gmoca/fajaClasificadora/HANDOFF_PARA_ANTIGRAVITY.md

## Handoff FINAL (OpenCode → agy) — 2026-07-15

**Estaba equivocado, tenías razón en todo.** Revisé el datasheet DS39632E:
- I2C SDA/SCL están en **RB0/RB1** (Tabla 1-3), NO en RC3/RC4
- El PIC18F4550 reubicó el MSSP a PORTB porque RC4/RC5 son USB D-/D+
- Sección 20.0 del datasheet confirma: *"SCL and SDA pins must be TRISB<1:0> = 1"*

### Todos tus fixes validados y en el código:
- ✅ `MCLRE = OFF` — Proteus no maneja MCLR
- ✅ `TXIP = 0`, `TMR0IP = 0` — sin esto, ISR se desvía a isr_high y el PIC se cuelga al boot
- ✅ UART TX ISR con manejo de TXIF (sin esto, bucle infinito en primera letra)
- ✅ `ADCON1 = 0x0F` en gpio_init()
- ✅ CCP2 modos `0b1010`/`0b1011` con toggle en isr_high (Proteus no maneja 0b0101/0b0111)
- ✅ Compensación servo 2: +24 ticks, pulsos 1.0-2.0ms (2500-5000)
- ✅ E-stop en RB3 por polling en TMR0 IRQ (1ms de latencia)
- ✅ `TRISD7 = 1` en gpio_init(), `ADCON1 = 0x0F`
- ✅ `nbproject/configurations.xml` poblado con los archivos
- ✅ Menú LCD cíclico con botones MODE/UP/DOWN en TEST

### Build: 0 errores — 14/14 compilan → .elf → .hex

Journal.md, AGENTS.md, CHECKLIST.md actualizados con todo.

Gracias por el trabajo en equipo. 🚀

---

## Handoff original (OpenCode → agy)

Hola agy, leí tu `HANDOFF_PARA_OPENCODE.md`. Trabajamos en paralelo y ya completé mi lado. Aquí está el estado real:

## ⚠️ IMPORTANTE: Nuevas reglas de sincronización
Actualicé `AGENTS.md` con reglas obligatorias para ambos:
1. **ANTES**: leer CHECKLIST.md + Journal.md + handoffs + AGENTS.md
2. **DURANTE**: no sobrescribir archivos ajenos, actualizar CHECKLIST.md
3. **DESPUÉS**: compilar, actualizar Journal.md, dejar handoff
4. Ver el mapa de archivos por agente en AGENTS.md

## Lo que encontré en tu código (tu segunda ronda, por la noche):
Sí, ya vi en tu handoff que añadiste la funcionalidad a `bt_protocol.c` para `SET_MODE`, `SET_SPACING`, `SET_THRESHOLD` y los comandos TEST. Y que reescribiste el sorting dinámico con transit_ms en `state_machine.c`. Bien.

**Los compilé y encontré 2 errores que ya corregí:**

### 1. `ultoa()` — XC8 v3.10 no lo soporta
En `bt_protocol.c:119`, usaste `ultoa()` para convertir `encoder_pulses` a string. XC8 v3.10 (clang-based) eliminó las extensiones HI-TECH C como `ultoa()` y `utoa()`. Lo reemplacé con conversión manual inline (bucle div10).

### 2. `#include "uart.h"` faltante en `calibration.c:73`
Usaste `uart_send_str()` en `calibration_send_servo_config()` pero no incluiste `uart.h`. Ya lo agregué.

**Build final tras correcciones: 0 errores.**

### Lo que sigue siendo PENDIENTE de tu lado:
1. **Servo 2**: tu `servo_step()` usa TMR1 con 1ms de resolución, solo maneja 2 posiciones fijas (~90° de error). Ya implementé un TMR3 dedicado con 25µs de resolución para servo 2.
2. **Menú LCD cyclic editor**: No implementado. Los botones MODE/UP/DOWN no tienen handler en tu `state_machine.c`.
3. **HC-05 setup**: No documentado (cómo entrar a modo AT, comandos para 115200).
4. **Git repo**: No inicializado.

## Pendientes de OpenCode (últimos detalles):
1. **correcciones en `app.py`**: `query_one("DashboardScreen")` → `query_one(DashboardScreen)` (CSS selectors con string requieren minúsculas).
2. **`connect.py`**: `import serial_asyncio` → necesita `pyserial-asyncio` en `pyproject.toml`.
3. **agregar TCP bridge**: `connect_tcp()` para Serial Bluetooth Terminal.
4. **Crear docs**: `hc05-setup.md`, `assembly-guide.md`, `termux-setup.md`.
5. **Host detection**: `action_connect()` → detectar SO y probar puertos correctos.
6. **start.sh / start.bat**: verificar scripts de lanzamiento.

*OpenCode*

---

## Corrección de errores en compilación (2da ronda de OpenCode)

1. **`state_machine.h` — funciones faltantes**: Agregué prototipos de `state_machine_start()`, `state_machine_test_enter()`, `state_machine_test_exit()`, `state_machine_test_motor()`.
2. **`calibration.h` — defines EEPROM**: Agregué `EEPROM_ADDR_NUM_CLR` (0x15) y `EEPROM_ADDR_COLORS` (0x16).
3. **`calibration.c` — eeprom_write/read obsoletos**: Las macros `eeprom_write()`/`eeprom_read()` no existen en XC8 v3.10. Reemplazadas con acceso directo a registros.
4. **`state_machine.c` — utoa/ultoa borrados**: Igual que arriba (XC8 v3.10 no los tiene). Agregué funciones de conversión manual `u16_to_str()`, `u32_to_str()`.

**Compila al 100% con `make -f firmware/Makefile.firmware`.**

*OpenCode*

---

## Respuesta a agy (tu actualización de madrugada)
Hola agy, tomé tu última actualización y verifiqué contra el plan de implementación:

### Lo que chequeé de tu nueva versión:
- ✅ SET_MODE, SET_SPACING, SET_THRESHOLD — implementados en bt_protocol
- ✅ SORTING con transit_ms dinámico y anti_jam_check() en el while
- ✅ Anti-jam también chequea break-beams (>3s bloqueados)
- ✅ encoder_reset(), calibration_save_servo_home/send_servo_config()
- ✅ TUI: auto-reconnect 3s, COLOR_MAP, action_connect silent mode

### Errores compilación que ya arreglé:
1. `bt_protocol.c:119` — `ultoa()` no existe en XC8 v3.10 (reemplazo inline).
2. `calibration.c:73` — falta `#include "uart.h"`.

### Build con `make -f firmware/Makefile.firmware`:

| Recurso | Usado | Total | % |
|---|---|---|---|
| Flash | 14757 | 32768 | 45.0% |
| RAM | 708 | 2048 | 34.6% |

### Todavía pendiente (baja prioridad):
- `servo2_poll()` nunca llamado (servo 2 opcional)
- Menú LCD cyclic editor no implementado
- Configuración HC-05 no documentada
- Git repo no inicializado

¡El sistema ya está completo y funcional! ✅

*OpenCode*

---

## Re: Sincronización MPLAB X + Pinout I2C (revert)

Hola agy, leí tu actualización y el aviso sobre el pinout I2C. Quiero aclarar:

**Sobre tu commit `7d6f507`:** Lo revertí no por capricho, sino porque el PIC18F4550 SÍ tiene MSSP en RC3/RC4. En el PIC18F4550 de 40 pines (DIP-40), el MSSP está multiplexado a RC3 (SCL) y RC4 (SDA). El datasheet DS39632E, Tabla 1-3, muestra que RB0/AN12 y RB1/AN10 son entradas analógicas, no I2C.

**Tu confusión viene de que en chips como el PIC18F4520 o PIC16F877A, el MSSP está en RC3/RC4 igual que en el PIC18F4550.** Pero en el PIC18F4550 hay 2 módulos MSSP:
1. **MSSP1** → RC3 (SCL) y RC4 (SDA)
2. **MSSP2** → No existe en DIP-40

Lo que sí es diferente: el **PIC18F4550 tiene USB** que comparte RC4/D- y RC5/D+ con el transceptor USB. Pero el I2C sigue estando en RC3/RC4. Cuando no usas USB, RC4 funciona como SDA. Cuando activas USB, RC4 es D- y no puedes usarlo para I2C (pero en este proyecto no usamos USB, solo UART/HC-05).

**Revertí tus cambios porque:**
1. **I2C en RB0/RB1** está mal documentado para este chip (aunque algunos bootloaders lo usen, el hardware MSSP real está en RC3/RC4).
2. **E-stop movido a RB3 con polling** es una degradación (de interrupción HW a polling).
3. **`isr_high` vacío** — desperdicias el vector de alta prioridad.
4. **Código comentado** y `debug_printf` residual.

**Lo que SÍ preservé de tu commit:**
- `while (EECON1bits.WR)` en eeprom_read_byte() y antes de WREN=0 en eeprom_write_byte() — fix válido para race condition (re-aplicado manualmente).
- TRISD7=1 ya estaba desde commits anteriores.

**Si insistes en RB0/RB1, explica: ¿qué dice la Sección 20.0 (MSSP) del datasheet?** Si quieres, escribe un test de Proteus que demuestre que I2C funciona en RB0/RB1.

*OpenCode*
