gmoca/fajaClasificadora/docs/termux-setup.md

# Configuración de Termux y PC para la TUI

## Requisitos

- Android 8+ con Bluetooth (para celular) o PC (Windows/Linux/macOS)
- Termux **desde F-Droid** (NO Google Play — versión desactualizada)
- HC-05 configurado a 9600 baud por defecto (o la velocidad configurada en `config.h`, ver [hc05-setup.md](file:///c:/Users/gusta/source/repos/gmoca/pryMicroFaja.X/docs/hc05-setup.md))

---

## Instalación y Arranque Rápido

### 1. Preparar Termux (Android) o PC
*   **En Android (Termux):** Abre la app y prepara los paquetes iniciales ejecutando:
    ```bash
    pkg update && pkg upgrade -y
    pkg install python clang make git -y
    ```
*   **En PC (Windows):** Asegúrate de tener instalado Python 3.8+ y Git agregados al PATH del sistema.

### 2. Clonar el repositorio
Abre tu terminal y ejecuta:
```bash
git clone https://github.com/gmoca/fajaClasificadora
cd fajaClasificadora/tui_app
```

---

### Opción A: Autoinstalación y Arranque (Recomendado / Más Rápido)

El proyecto cuenta con scripts que automatizan la creación de un entorno virtual aislado de Python (`.venv`), instalan las dependencias necesarias (`textual`, `pyserial-asyncio`, etc.) y lanzan la aplicación TUI con un solo comando.

*   **En Android (Termux) o Linux/macOS:**
    Dale permisos de ejecución al script `start.sh` y ejecútalo:
    ```bash
    chmod +x start.sh
    ./start.sh
    ```
*   **En Windows:**
    Simplemente haz doble clic en `start.bat` o ejecútalo desde tu consola:
    ```cmd
    start.bat
    ```

> [!NOTE]
> Estos scripts son inteligentes: en la primera ejecución descargarán e instalarán todo de forma transparente, y en los arranques posteriores iniciarán la TUI directamente en milisegundos.

---

### Opción B: Instalación Manual Paso a Paso (Alternativo)

Si prefieres realizar la instalación y configuración manualmente sin usar los scripts:

1.  **Crear y activar el entorno virtual:**
    *   *En Termux / Linux / macOS:*
        ```bash
        python -m venv .venv
        source .venv/bin/activate
        ```
    *   *En Windows (PowerShell):*
        ```powershell
        python -m venv .venv
        .venv\Scripts\Activate.ps1
        ```
2.  **Instalar dependencias:**
    Instala los paquetes en modo editable utilizando el archivo de configuración del proyecto:
    ```bash
    pip install --upgrade pip
    pip install -e .
    ```
3.  **Lanzar la TUI:**
    ```bash
    python app.py
    ```

---

## Conexión Bluetooth

Hay dos métodos de vinculación en celular. Se recomienda el segundo (Método B) porque no requiere root.

### Método A: Directo por rfcomm (requiere root)

```bash
# Escanear dispositivos Bluetooth
sudo hcitool scan

# Vincular con la dirección MAC del HC-05
# (hacer desde Ajustes → Bluetooth del teléfono)

# Crear el puerto serie virtual
sudo rfcomm bind 0 <MAC_DEL_HC05> 1

# Probar
python app.py
# La app intentará /dev/rfcomm0 automáticamente
```

### Método B: Bluetooth TCP Bridge (recomendado, sin root)

Usa la app **Bluetooth TCP Bridge** (del desarrollador Marek Masár) en Android como puente TCP local.

#### Pasos:

1.  **Parear el HC-05** desde Ajustes → Bluetooth del teléfono.
2.  **Abrir la app Bluetooth TCP Bridge**.
3.  Seleccionar tu módulo HC-05 en la sección de dispositivos Bluetooth.
4.  Ir a la sección de configuración de red dentro de la app y habilitar el **TCP Server**.
5.  Elegir puerto **8080** (o 9000 / 1234).
6.  Conectar ambos extremos.
7.  En Termux, ejecuta la TUI con el script automático o comando manual.
    La TUI detectará que corre en Termux e intentará la conexión TCP local de forma inmediata.

#### Verificar conexión:

```bash
python -c "
import asyncio
async def test():
    r, w = await asyncio.open_connection('127.0.0.1', 8080)
    w.write(b'STATUS\n')
    await w.drain()
    data = await asyncio.wait_for(r.readline(), timeout=2)
    print('Respuesta:', data.decode().strip())
    w.close()
asyncio.run(test())
"
```

Debería responder: `STATUS_RESP:...`

### Método C: Conexión Remota por Red Local (LAN) - PC sin Bluetooth

Si tu PC no tiene antena Bluetooth, pero tu celular y la PC están conectados a la **misma red local** (por ejemplo, la PC por cable Ethernet RJ45 y el celular por WiFi), puedes usar el celular como antena repetidora:

1.  Asegúrate de que ambos dispositivos están conectados al mismo módem/router.
2.  En la app **Bluetooth TCP Bridge** de tu celular, ve a la sección de red y fíjate qué dirección IP local tiene asignada (ejemplo: `192.168.1.15`).
3.  Inicia el **TCP Server** en el puerto `8080` de tu celular y conéctate al módulo HC-05 por Bluetooth.
4.  En la PC, abre la terminal e inicia la TUI especificando la IP de tu celular:
    ```powershell
    python app.py --ip DIRECCION_IP_DEL_CELULAR
    ```
    *(Por ejemplo: `python app.py --ip 192.168.1.15`)*

### Método D: USB-OTG + cable USB-TTL (alternativa sin Bluetooth en Termux)

Si no usas Bluetooth, puedes conectar un cable USB-TTL directamente al PIC:

```
USB-TTL → HC-05 (solo RX/TX, sin alimentar)
O directo al PIC: TX→RC7, RX→RC6
```

Conectas el cable USB-TTL al teléfono vía USB-OTG. En Termux:

```bash
# Instalar soporte USB serie
pkg install usbutils
lsusb  # debe aparecer el adaptador USB-TTL
# Normalmente aparece como /dev/ttyUSB0 o /dev/ttyACM0

python app.py
# La app intentará /dev/ttyUSB0 automáticamente
```

---

## Parámetros de ejecución avanzados (CLI)

Puedes configurar el comportamiento de conexión de la TUI al arrancar desde la terminal usando los siguientes argumentos:

*   `--ip <IP>`: Dirección IP del servidor TCP del celular (Por defecto `127.0.0.1`).
*   `--port <PORT>`: Puerto de conexión TCP (Por defecto `8080`).
*   `--serial <PORT_COM>`: Forzar conexión directa a un puerto COM serie físico (Ej: `COM5` en Windows o `/dev/ttyUSB0` en Linux).

*Ejemplo de uso:* `python app.py --ip 192.168.3.4 --port 8080`

---

## Solución de problemas

| Problema | Causa | Solución |
|---|---|---|
| `ModuleNotFoundError: serial` | Faltan dependencias | Ejecutar con `start.sh` / `start.bat` o correr `pip install -e .` en el entorno virtual activo. |
| `Connection refused` al conectar TCP | Serial BT Terminal no inició TCP Server | Abrir app, menú → TCP Server → Start |
| `No device` en TCP | Puerto incorrecto | Verificar puerto en la app (debe ser 8080, 9000 o 1234) |
| Datos corruptos o caracteres raros | Baud rate incorrecto | El baud rate del HC-05 debe coincidir con `config.h` del firmware (por defecto 9600). |
| `git clone` falla | Sin git | `pkg install git` |
| La TUI no responde | HC-05 no conectado | Verificar LED del HC-05 (debe parpadear rápido) |
