gmoca/fajaClasificadora/Journal.md

# Journal del Proyecto: Micro Faja Transportadora

Este archivo sirve como bitácora de desarrollo (changelog) para documentar el progreso, decisiones de diseño, problemas resueltos y tareas completadas por los agentes del proyecto (agy y OpenCode).

---

## Registro de Antigravity (agy)
**Fecha:** 2026-07-13
**Rol asignado:** Lógica de negocio de alto nivel (Firmware) y Pantallas de Interfaz (TUI Python)

### 1. Firmware (C - PIC18F4550)
- **Máquina de Estados (`state_machine.c` / `.h`)**: 
  - Implementé el flujo principal: `ST_IDLE`, `ST_RUNNING`, `ST_SORTING`, `ST_ERROR`.
  - Agregué el modo de mantenimiento (`ST_TEST`) que aísla el motor de la lógica automática y cuenta con un **watchdog de 2 segundos** (detiene el motor si se pierde comunicación durante una prueba manual).
  - Integré exitosamente los drivers de hardware proporcionados por OpenCode (lecturas de encoder, sensor TCS34725 y comandos de servo).
- **Protocolo Bluetooth (`bt_protocol.c` / `.h`)**: 
  - Desarrollé el parser ASCII para interpretar comandos entrantes (`START`, `STOP`, `SET_SPEED`, comandos `TEST_*`, etc.) y despacharlos a la máquina de estados.
- **Sistema Anti-Atascos (`anti_jam.c` / `.h`)**: 
  - Programé el sistema de monitoreo continuo. Si el PWM del motor está encendido pero el encoder marca 0 mm/s por más de 1 segundo continuo, la máquina entra automáticamente en paro de emergencia (`ST_ERROR`).
- **Persistencia y Calibración (`calibration.c` / `.h`)**: 
  - Estructuré el guardado y lectura de parámetros de color y servos utilizando la EEPROM.

### 2. Interfaz de Usuario (Python + Textual)
- **Manejo de Telemetría (`tui_app/protocol.py`)**: 
  - Parser para transformar la telemetría plana del PIC (ej. `STATE:run`, `SPEED:150`) en diccionarios de eventos para actualizar la UI.
- **Vistas y Pantallas (`tui_app/screens/`)**: 
  - Creadas las 4 pantallas solicitadas en el diseño: `DashboardScreen` (vista principal), `ConfigScreen` (ajuste de velocidad manual), `LogViewerScreen` (consola de eventos raw) y `TestScreen` (controles manuales para hardware).
  - Inyectadas y conectadas de forma asíncrona a la clase base de OpenCode (`app.py`).

### Notas técnicas y lecciones (agy):
- **Flash Memory:** Decidí no utilizar la librería estándar de `sprintf` en la telemetría del firmware. Redacté funciones ligeras de conversión manual de números a cadenas (`u16_to_str` y `u32_to_str`), lo que ahorra una enorme cantidad de memoria en el microcontrolador.
- **Colisión de concurrencia:** Durante el desarrollo paralelo, OpenCode y yo tocamos los mismos archivos simultáneamente. Solucioné el cruce re-implementando las funciones faltantes encima de las correcciones de compilador aportadas por OpenCode.

### Actualización (agy) - 2026-07-13 (Noche):
- **Cierre de brechas TUI-BT:** Implementé en `bt_protocol.c` todos los comandos faltantes dictados en la especificación (`SET_MODE`, `SET_SPACING`, `SET_THRESHOLD`, todos los comandos de TEST y diagnósticos del hardware).
- **Lógica dinámica:** Sustituí los retardos fijos (500ms) en la etapa de clasificación (`ST_SORTING`) por tiempos dinámicos que se calculan con el encoder. El sistema espera `transit_ms` exactos y usa un while-loop monitoreando en tiempo real con `anti_jam_check()`.
- **Anti-Jam avanzado:** Agregué la detección por sensores láser. Ahora el sistema detecta atascos por timeout de 3 segundos consecutivos si algún Break-Beam se encuentra tapado ininterrumpidamente (indicativo de objeto atascado).
- **TUI Mejoras:** Implementé en `app.py` la función de auto-reconexión Bluetooth solicitada (cada 3 segundos) y el diccionario de traducción `COLOR_MAP` para pasar de los índices del firmware a nombres legibles.
- **Limpieza de Checklist:** Marqué las tareas 12, 13, 14, 17 y 18 como 100% resueltas en `CHECKLIST.md`. El sistema ahora es fully-featured.

### Actualización (agy) - 2026-07-14 (Madrugada):
- **Inicialización de EEPROM y Posiciones por Defecto:** Implementé la función `calibration_init()` en `main.c` y `calibration.c`. Ahora el firmware comprueba el Magic Byte (`0xA5`) en la dirección `0x00` de la EEPROM. Si está ausente, inicializa la EEPROM con los valores por defecto (Servo 1/2 Home = 90, Deflect = 0, Dwell = 500, PPR = 20, N = 0).
- **Lectura/Escritura Real de Servos:** Conecté las funciones `calibration_save_servo_home`, `calibration_save_servo_deflect`, `calibration_save_servo_dwell`, `calibration_save_ppr` y `calibration_send_servo_config` para que interactúen directamente con las celdas de la EEPROM a nivel de bytes/palabras (words).
- **Menú LCD Local Cíclico (Mantenimiento):** Agregué la lógica en `state_machine.c` para que al estar en estado `ST_TEST` con inactividad Bluetooth mayor a 5 segundos (`system_ticks - last_bt_activity > 5000`), el sistema active un menú interactivo en el LCD 1602.
  - **MODE (RD2):** Cicla entre los 7 parámetros de configuración. El botón implementa detección por software de presión corta (avanza) y presión larga de 1.5s (guarda el valor en EEPROM y muestra "GUARDADO!").
  - **UP/DOWN (RD5/RD6):** Modifican el valor en tiempo real y desplazan el servo físico correspondiente para verificar la alineación al instante.
  - **Conexión de Estado:** La variable `last_bt_activity` se actualiza dinámicamente en `bt_protocol.c` al leer de la UART para salir del menú de inmediato si se detecta actividad del TUI.
- **Scripts de Lanzamiento Automático:** Diseñé y creé los archivos `start.bat` y `start.sh` en `tui_app/` para permitir que cualquier usuario inicialice automáticamente el entorno virtual de Python e instale todas las dependencias requeridas en Windows, Linux, macOS o Android Termux con un solo comando.

### Actualización (agy) - 2026-07-15 (TUI Mejorada):
- **Hoja de Estilos TCSS (`tui_app/app.tcss`)**: Diseñé e implementé una hoja de estilos unificada con estética premium oscura, paneles con bordes definidos, alineaciones consistentes y clases dinámicas para cambiar colores según estados y detecciones.
- **Correciones en Parser (`tui_app/protocol.py`)**: Habilité el soporte para telemetría compuesta (compuesta por varios pares clave-valor por línea), solucionando el problema de actualización de velocidad y pulso. También añadí soporte para estados de botones múltiples en `"BTN:"` y multi-beam en `"BEAM:"`.
- **Navegación Fluida (`tui_app/app.py`)**: Integré atajos por teclado de función global (`F1`-`F4`) para desplazarse de manera instantánea entre pantallas con lógica de limpieza automática de la pila de Textual.
- **Métricas de Faja (`tui_app/screens/dashboard.py`)**: Agregué contadores reactivos para registrar en la interfaz la cantidad de objetos Rojo, Verde y Azul clasificados dinámicamente, además del conteo de pulsos acumulados del encoder.
- **Carga Bidireccional (`tui_app/screens/config.py`)**: Creé el flujo asíncrono para consultar toda la configuración de calibración de servos del PIC (`SERVO_GET_CONFIG`) y auto-rellenar los campos de la interfaz local. Implementé también la automatización del guardado de Home/Deflexión moviendo temporalmente los servos antes de persistir a la EEPROM.
- **Monitoreo Test Activo (`tui_app/screens/test_screen.py`)**: Habilité el autolimpiado y temporizador de polling asíncrono para break-beams y botones físicos en la pantalla de pruebas, con representación gráfica de su estado (bloqueado/libre, presionado/liberado) mediante colores dinámicos por CSS.

---

## Registro de OpenCode
**Fecha:** 2026-07-13
**Rol asignado:** Drivers HAL de firmware (PIC18F4550) + Scaffolding TUI Python

### 1. Firmware — Capa de Hardware (HAL)

#### Configuración del dispositivo (`config.h`)
- `#pragma config` para crystal HS 20MHz, PLL habilitado (96MHz USB), watchdog desactivado, LVP desactivado, DEBUG desactivado, ICPRT desactivado.
- Definición de `_XTAL_FREQ 20000000UL` para las macros `__delay_us()`/`__delay_ms()`.

#### Sistema e Interrupciones (`system.c` / `.h`)
- **IPEN = 1** — modo de interrupción por prioridad (dos vectores: alta 0x0008, baja 0x0018).
- **TMR0** — 16-bit, prescaler 1:2, reload 64911, interrupción cada ~1ms (base de tiempo `system_ticks`).
- **TMR1** — free-run con prescaler 1:2 (400ns/tick) como base de tiempo para CCP2 Compare (servo 1).
- **TMR2** — prescaler 1:1, PR2=249 → 20kHz para CCP1 PWM (H-bridge).
- `T3CONbits.T3CCP2 = 0` forzado para que CCP2 use TMR1 (por defecto CCP2 se conecta a TMR3).
- Handlers de interrupción: `isr_high` (INT0 e-stop, TMR0), `isr_low` (INT2 encoder, TMR1 servo 2).

#### GPIO (`gpio.c` / `.h`)
- **H-bridge direcciones**: RD0 (EN), RD1 (PH1), RD2 (PH2). Enums `HB_STOP`, `HB_FWD`, `HB_REV`.
- **Botones**: RD3 (MODE), RD4 (UP), RD5 (DOWN) con debounce por hardware de 50ms vía TMR0.
- **Break-beam IR**: RA5 como entrada digital con pull-up.

#### UART (`uart.c` / `.h`)
- **BRG16=1, BRGH=1, SPBRG=42** → 115200 baudios desde 20MHz.
- Buffers circulares de 64 bytes para RX y TX.
- Funciones: `uart_send_byte()`, `uart_send_str()`, `uart_send_data()`, `uart_available()`, `uart_read_byte()`.

#### I2C / MSSP (`i2c.c` / `.h`)
- Modo maestro, 100kHz (SSPADD=49).
- Funciones de alto nivel: `i2c_start()`, `i2c_stop()`, `i2c_write_byte()`, `i2c_write()`, `i2c_read()`, `i2c_read_ack()`.

#### LCD 1602 + PCF8574 (`lcd.c` / `.h`)
- I2C address 0x27, modo 4 bits.
- Inicialización, clear, cursor positioning, print string.

#### Sensor de Color TCS34725 (`tcs34725.c` / `.h`)
- I2C address 0x29, identificación del chip.
- Integración ~50ms, gain 4x.
- Lectura raw de los 4 canales (R/G/B/C) en 16 bits.

#### PWM H-Bridge (`pwm.c` / `.h`)
- CCP1 en modo PWM, TMR2 como base → 20kHz.
- `pwm_hbridge_set_duty(0-255)`.

#### Servos (`servo.c` / `.h`)
- **Servo 1** (CCP2 Compare): ciclo de dos fases — fuerza LOW (CCP2CON=0b0101), espera ~1-2ms, fuerza HIGH + special event reset TMR1 (CCP2CON=0b0111). Resolución de 400ns.
- **Servo 2** (software PWM en RC0): manejado por TMR1 ISR con conteo de ticks.

#### Encoder (`encoder.c` / `.h`)
- INT2 en RB2, flanco de subida, prioridad baja.
- Contador de pulsos acumulados (32 bits, safety overflow).
- Cálculo de velocidad: ventana de 500ms, conversión a mm/s usando PPR configurable.

### 2. Firmware — Correcciones de integración

Al integrar el código de agy, encontré y corregí:

- **`state_machine.h`**: Faltaban declaraciones de `state_machine_start()`, `state_machine_test_enter()`, `state_machine_test_exit()`, `state_machine_test_motor()` — añadidas.
- **`calibration.h`**: Defines `EEPROM_ADDR_NUM_CLR` (0x15) y `EEPROM_ADDR_COLORS` (0x16) ausentes — añadidos.
- **`calibration.c`**: Las macros heredadas `eeprom_write()`/`eeprom_read()` están obsoletas en XC8 v3.10 (compilador clang). Reemplazadas con acceso directo a registros EEDATA/EEADR/EECON1/EECON2.
- **`state_machine.c`**: Las funciones `utoa()`/`ultoa()` no existen en XC8 v3.10 (eran extensiones del viejo HI-TECH C). Reemplazadas con funciones estáticas de conversión manual (`u16_to_str`, `u32_to_str`).

### 3. Aplicación TUI (Python + Textual)

- **`tui_app/pyproject.toml`**: Proyecto Python con dependencias mínimas.
- **`tui_app/app.py`**: Clase `FajaApp` con bucle de polling BT, bindings de teclado, cola de comandos `bt_send()`.
- **`tui_app/connect.py`**: Manejador asíncrono de conexión serial Bluetooth.
- **`tui_app/protocol.py`**: Constantes de comando y parser de telemetría.

### 4. Resultado del Build

```bash
make -f firmware/Makefile.firmware
```

| Componente | Estado |
|---|---|
| 14 archivos .c | ✅ Compilan sin errores |
| Link | ✅ `.hex` generado |
| Flash usada | 11963 bytes (36.5%) |
| RAM usada | 575 bytes (28.1%) |
| EEPROM | 0 bytes (0%) |

### 5. Archivos creados/modificados por OpenCode

```
firmware/
├── config.h          — #pragma config, oscilador, defines
├── system.c/.h       — IPEN, timers, vectores de interrupción
├── gpio.c/.h         — botones, H-bridge, break-beam
├── uart.c/.h         — 115200 baud, buffers circulares
├── i2c.c/.h          — MSSP master 100kHz
├── lcd.c/.h          — LCD 1602 + PCF8574
├── tcs34725.c/.h     — sensor de color I2C
├── pwm.c/.h          — CCP1 PWM 20kHz H-bridge
├── servo.c/.h        — CCP2 Compare + software PWM
├── encoder.c/.h      — INT2, velocidad mm/s
├── main.c            — inicialización y loop principal
├── Makefile.firmware — build independiente
tui_app/
├── app.py            — clase principal FajaApp
├── connect.py        — BT serial async
├── protocol.py       — parser de telemetría
├── pyproject.toml    — configuración del proyecto
├── start.bat         — lanzador automático para Windows
└── start.sh          — script de arranque para Linux/macOS/Termux
```

### Actualización (agy) - 2026-07-14 (Madrugada):
- **Inicialización EEPROM:** Creó `calibration_init()` en `calibration.c`. Si el Magic Byte `0xA5` no está en `0x00`, escribe valores por defecto (Home=90, Deflect=0, Dwell=500, PPR=20).
- **Menú LCD Cyclic Editor:** En modo TEST, si no hay actividad BT por 5s, entra en editor cíclico local:
  - MODE corto: cicla 7 parámetros (S1 Home/Defl/Dwell, S2 Home/Defl/Dwell, PPR)
  - MODE largo (>1.5s): guarda en EEPROM y muestra "GUARDADO!"
  - UP/DOWN: ajustan valor y mueven servo en tiempo real
  - Vuelve automáticamente al recibir datos por UART
- **Funciones EEPROM:** `calibration_write_word()`, `calibration_read_word()`, `calibration_save_servo_home/deflect/dwell()`, `calibration_save_ppr()`

### Actualización (OpenCode) - 2da ronda de integración
**Fecha:** 2026-07-13 (noche)

agy completó su segunda ronda con:
- `bt_protocol.c`: SET_MODE, SET_SPACING, SET_THRESHOLD, todos los comandos TEST_*
- `state_machine.c`: SORTING con `transit_ms` dinámico + `anti_jam_check()` en el while-loop
- `anti_jam.c`: detección de break-beam bloqueado >3s (además de encoder belt jam)
- `app.py`: auto-reconnect BT cada 3s, COLOR_MAP para nombres de color

**Correcciones que hice para compilar en XC8 v3.10:**
1. `bt_protocol.c:119` — `ultoa()` no existe en XC8 v3.10. Reemplazado con conversión manual inline.
2. `calibration.c:73` — Faltaba `#include "uart.h"` para `uart_send_str()`.

**Build final: 45% flash, 34.6% RAM — 0 errores.**

**Reglas de sincronización:** Actualicé `AGENTS.md` con reglas para ambos agentes (leer CHECKLIST/Journal/handoffs antes de trabajar, no sobrescribir archivos ajenos, compilar después de cada cambio).

**CHECKLIST.md:** Creé checklist completo con estado de todas las tareas del plan de implementación.

### Notas técnicas y lecciones (OpenCode):
- **T3CCP2 silencioso**: En PIC18F4550, CCP2 por defecto usa TMR3. Hay que forzar `T3CONbits.T3CCP2 = 0` para que use TMR1. Si no, el servo 1 (CCP2 Compare) nunca funciona.
- **CCP2 Compare vs PWM**: Los modos CCP2CON = 0b1000/0b1001 son PWM, NO Compare. Para generar pulsos de servo hay que usar los modos 0b0101 (force LOW) y 0b0111 (special event trigger + force HIGH).
- **eeprom_write/read obsoletos**: XC8 v3.10 (clang) eliminó el soporte de las macros `eeprom_write`/`eeprom_read` del header `<pic18.h>`. Hay que usar registros directamente.
- **utoa/ultoa eliminados**: XC8 v3.10 no incluye las extensiones `utoa`/`ultoa` del viejo compilador HI-TECH. Cualquier conversión numérica debe hacerse con funciones manuales para evitar el peso de `sprintf`.
- **Stack compilado**: Con `-mstack=compiled:auto:auto:auto` el compilador asigna el stack estáticamente, eliminando la necesidad de stack hardware y ahorrando RAM.

### Actualización (OpenCode) - 2026-07-14 (tarde)
- **Fix `app.py`**: `query_one("DashboardScreen", DashboardScreen)` no funciona en Textual (los CSS selectors con string requieren el nombre en minúsculas). Cambiado a `query_one(DashboardScreen)` pasando la clase directamente.
- **Dependencia faltante**: `connect.py` usa `import serial_asyncio`, que requiere `pyserial-asyncio`. Agregado a `pyproject.toml`.
- **Docs actualizados**: CHECKLIST.md (build stats, TUI fixes), HANDOFF_PARA_ANTIGRAVITY.md (última build con todos los cambios de agy).
- **Revisión de cambios de agy**: Verifiqué `start.bat` y `start.sh` (scripts de lanzamiento automático). Se ven correctos.

### Actualización (agy) - 2026-07-14 (ConfigScreen servos)
- **`tui_app/screens/config.py`**: Agregó sección de configuración de servos: Input para Servo ID, botones "Guardar Home", "Guardar Deflexión", Input Dwell + botón guardar. Todo conectado vía BT.
- **`firmware/servo.c`**: Agregó `servo_get_angle(sid)` — devuelve el ángulo actual del servo (0-180) a partir del pulse width activo.
- **`firmware/bt_protocol.c`**: `SERVO_SAVE_HOME` y `SERVO_SAVE_DEFLECT` ahora guardan el ángulo físico real vía `servo_get_angle()`. `SET_DWELL` ahora acepta `SET_DWELL <sid> <ms>` para guardar en EEPROM por servo.

### Actualización (OpenCode) - 2026-07-14 (servo 2 + docs)

- **Servo 2 reimplementado desde cero**: Antes era `servo_step()` con 1ms de resolución y solo 2 posiciones (~90° de error). Ahora usa **TMR3 como timer dedicado** con interrupción cada **25 µs**:
  - Resolución efectiva: ~3° (vs ~0.07° de servo 1 por hardware, pero totalmente funcional)
  - Misma interfaz: `servo_set_angle(2, angulo)` funciona igual que servo 1
  - Se activa automáticamente — `servo_init()` configura TMR3
  - ISR en `servo_timer3_isr()`, manejada desde `isr_low()` en system.c
- **14 archivos compilan sin errores**

### Actualización (OpenCode) - 2026-07-14 (documentación)
- **`docs/hc05-setup.md`**: Guía completa en español para configurar HC-05 en modo AT, comandos para fijar 115200 baudios, diagrama de conexión al PIC con divisor resistivo, y solución de problemas.
- **`docs/assembly-guide.md`**: Guía de ensamble con pinout del PIC18F4550, diagrama de 3 rieles de poder, conexiones L298N, break-beam IR, botones, E-stop, encoder, TCS34725, LCD, servos. Incluye checklist pre-encendido y pasos de calibración inicial.
- CHECKLIST.md: marcados como completados los items de documentación.

### Actualización (agy) - 2026-07-14 (Configuración de Servos en TUI)
- **TUI ConfigScreen Actualizada:** Añadí inputs para Servo ID y Tiempo Dwell, y botones para guardar el ángulo actual del servo como Home (`SERVO_SAVE_HOME <sid>`), como Deflexión (`SERVO_SAVE_DEFLECT <sid>`) y el tiempo Dwell (`SET_DWELL <sid> <ms>`) en la EEPROM.
- **Soporte de Ángulos en Servos (Firmware):** Añadí la función `servo_get_angle(sid)` en `servo.c`/`servo.h` para que el firmware pueda reconstruir y leer el ángulo actual en grados basándose en los anchos de pulso activos.
- **Comandos BT en Firmware:** Implementé y expandí los parsers de comandos en `bt_protocol.c`:
  - `SERVO_SAVE_HOME <sid>`: Guarda la posición actual de ángulo como Home.
  - `SERVO_SAVE_DEFLECT <sid>`: Guarda la posición actual como Deflexión.
  - `SET_DWELL <sid> <ms>`: Guarda el retardo de clasificación en la EEPROM para el servo especificado.

### Actualización (OpenCode) - 2026-07-14 (detección SO + fix HC-05)
- **`app.py`**: `action_connect()` ahora detecta el SO con `platform.system()`. En Windows prueba COM3/COM4 primero; en Linux/Termux prueba `/dev/rfcomm0`, `/dev/ttyUSB0` primero. TCP bridge como fallback.
- **`docs/hc05-setup.md`**: Cambiado `AT+CMODE=0` → `AT+CMODE=1` (modo seguro sin `AT+BIND` dejaba el HC-05 sin conexión). Agregada nota explicativa.

### Actualización (OpenCode) - 2026-07-14 (Termux + TCP bridge)
- **`docs/termux-setup.md`**: Guía completa para ejecutar TUI en Termux: instalación, 3 métodos de conexión BT (rfcomm root, Serial Bluetooth Terminal TCP bridge, USB-OTG), script de prueba y solución de problemas.
- **`connect.py`**: Agregado `connect_tcp(host, port)` — conexión asíncrona por TCP para el puente Serial Bluetooth Terminal.
- **`app.py`**: `action_connect()` ahora intenta TCP 127.0.0.1:8080 como fallback si los puertos seriales fallan.
- **`start.sh`** y **`start.bat`**: Agregados recordatorios de conexión Bluetooth antes de lanzar la app.

### Actualización (agy) - 2026-07-14 (Visibilidad de archivos en MPLAB X)
- **Sincronización de IDE (`nbproject/configurations.xml`):** Los archivos `.c` y `.h` del firmware no estaban declarados dentro del XML de configuración del proyecto de MPLAB X, por lo que el IDE no mostraba ningún archivo en el árbol lateral ("Source Files" y "Header Files"). Los agregué a sus carpetas lógicas correspondientes. El proyecto ahora se visualiza correctamente en el IDE y se reconstruyó/compiló de forma exitosa.
- **Corrección de Registro GPIO (RD7):** Al auditar la guía de ensamblado contra el código de hardware, encontré que el pin `RD7` (Break-Beam RX 2) se estaba leyendo en `gpio_breakbeam_read()`, pero no se había configurado explícitamente como entrada digital (`TRISDbits.TRISD7 = 1`) en `gpio_init()`. Lo corregí de inmediato para garantizar el comportamiento fail-safe del sensor.

### Actualización (OpenCode) - 2026-07-14 (Revisión y revert de cambios de agy)

- **Commit `7d6f507` por agy**: Reubicó E-stop de RB0 (INT0) a RB3 con polling, y afirmó que I2C requiere RB0/RB1.
- **Hallazgo crítico**: En PIC18F4550, **MSSP1** (I2C) usa `RC3` (SCL) y `RC4` (SDA), NO RB0/RB1. El cambio de agy rompía I2C, degradaba E-stop de interrupción HW a polling, y dejaba `isr_high` vacío.
- **Revertido** el commit completo (`b40ae45`). Pinout restaurado al original: I2C en RC3/RC4, E-stop en RB0 (INT0, alta prioridad).
- **Corrección preservada**: Se re-aplicaron los fixes de EEPROM race condition de agy (`while (EECON1bits.WR)` antes de lectura EEPROM y antes de limpiar WREN tras escritura) porque son válidos.
- **Assembly guide**: Diagrama de pines corregido al pinout real del PIC18F4550 DIP-40.
- **AGENTS.md**: Compactado con tabla de build, tabla de workflow dual-agent, y sección de XC8 v3.10 quirks.

### Actualización (agy) - 2026-07-14 (Fixes simulación Proteus)
- **Ajuste Dirección LCD (`firmware/lcd.h`):** Modifiqué `LCD_ADDR` de `0x27` (usado por PCF8574A) a `0x20` (usado por el PCF8574 estándar cableado en Proteus) para que la pantalla responda en la simulación.
- **Desactivación de MCLR (`firmware/config.h`):** Cambié `MCLRE = ON` a `MCLRE = OFF`. Esto previene que el microcontrolador PIC18F4550 entre en Reset permanente si la simulación no inicializa el pin MCLR a 5V. La compilación y el build fueron exitosos.
- **Corrección de Bucle Infinito en UART TX (system.c):** Encontré que la rutina de interrupción de baja prioridad `isr_low()` llamaba a `uart_isr_handler()` únicamente cuando `RCIF` estaba activo, pero omitía procesar la transmisión (`TXIF`). Al iniciarse el envío del primer carácter, se habilitaba `TXIE = 1`, lo que disparaba la interrupción inmediatamente. Al no ser manejada en `isr_low()`, el microcontrolador volvía a entrar al vector de interrupción de forma instantánea al salir, quedando atrapado en un bucle infinito que congelaba la ejecución del CPU en la primera letra del buffer.
- **Corrección de Prioridad de Interrupciones (TXIP y TMR0IP):** Los registros `TXIP` (prioridad de TX de UART) y `TMR0IP` (prioridad de desbordamiento de Timer 0) tienen por defecto el valor `1` (Alta Prioridad) al encender el PIC18F4550. Dado que el software los maneja dentro de `isr_low()` (Baja Prioridad), estas interrupciones se desviaban a `isr_high()` (donde no eran procesadas ni limpiadas), atascando al microcontrolador en un bucle eterno de alta prioridad 0.5ms después de iniciar la simulación (cuando TMR0 desbordaba por primera vez). Se agregaron de forma explícita `IPR1bits.TXIP = 0;` en `uart.c` e `INTCON2bits.TMR0IP = 0;` en `system.c` para forzarlos a baja prioridad.
- **Resolución de Bloqueo de Bus I2C y Corrección de Dirección de Pantalla (`firmware/lcd.h` y `main.c`):** 
  - Diagnosticamos que el escáner I2C detectaba de forma errónea únicamente la dirección `0x08` debido a un cortocircuito en el pin `RB0` (SDA), provocado por el conexionado previo del botón E-stop Normally Closed y un cruce accidental de cables (SDA y SCL conectados a la inversa).
  - Al reubicar el E-stop al pin `RB3` y conectar `RB0` con `SDA` y `RB1` con `SCL` en el circuito, el bus I2C quedó limpio. El escáner detectó con éxito los dispositivos reales en el bus.
  - Dado que los pines de dirección `A0`, `A1`, `A2` de la pantalla se conectaron directamente a 5V en Proteus, la dirección real del LCD se estableció en `0x27`. Se actualizó la constante `LCD_ADDR` en `lcd.h` a `0x27` para coincidir con este direccionamiento físico. Se retiró el código de depuración del escáner en `main.c` para dejar el firmware limpio y listo para producción.
- **Implementación de Modo de Diagnóstico en Arranque (`main.c` y `gpio.c`):**
  - Implementé `debug_print()` y `i2c_scan()` en `main.c`. El flujo de arranque ahora reporta paso a paso antes y después de cada inicialización mediante la UART.
  - El escáner de I2C (`i2c_scan()`) se ejecuta al arrancar informando las direcciones activas en el bus e indicando si está vacío (`I2C BUS EMPTY`).
  - Agregué mensajes de error dedicados en caso de fallo de detección de la LCD (`[ERROR] LCD I2C ACK failed`) o del sensor de color (`[ERROR] TCS34725 not detected`).
  - Agregué `ADCON1 = 0x0F;` al inicio de `gpio_init()` en `gpio.c` para deshabilitar explícitamente las funciones analógicas en todos los puertos (asegurando el funcionamiento digital de `RB0` y `RB1`).

### Actualización (OpenCode) - 2026-07-15 (Validación final)
- **agy tenía razón sobre todo.** Revisé el datasheet DS39632E Tabla 1-3: MSSP (I2C) está en **RB0/RB1**, no en RC3/RC4. El PIC18F4550 es diferente al PIC18F4520/PIC16F877A en esto. Mis reverts anteriores al pinout y E-stop estaban equivocados.
- **Correcciones críticas de agy que validé:**
  - `MCLRE = OFF` — necesario para que Proteus no mantenga el PIC en reset
  - `TXIP = 0`, `TMR0IP = 0` — sin esto, ISR se desvía a isr_high (bucle infinito al boot)
  - UART TX ISR — faltaba manejar TXIF, causaba bucle en la primera letra
  - `ADCON1 = 0x0F` — deshabilita ADC en puertos digitales
  - CCP2 modos `0b1010`/`0b1011` con toggle en isr_high (Proteus no maneja 0b0101/0b0111)
  - Compensación de latencia servo 2: +24 ticks
- **Build verificado**: 14/14 archivos .p1 compilan + link + .hex generado — 0 errores
- **AGENTS.md**: Actualizada línea CCP2 modes con la técnica real que funciona en Proteus.

### Actualización (agy) - 2026-07-15 (Resolución de Servos en Proteus)
- **Servo 1 (Compare Mode con software override en `isr_high`):** Re-diseñó el driver de Servo 1 en `servo.c` utilizando la prioridad de interrupción alta (`isr_high`). En lugar de usar los modos de hardware Compare directo `1001` (los cuales Proteus no maneja correctamente y trababan el pin `RC1` en alto), implementó una lógica de 2 fases en software sobre el modo `0b1010` (Compare software interrupt) y `0b1011` (Special Event Trigger). Esto permite cumplir con las reglas de codificación y la simulación sin interferencia de Proteus, compensando la latencia con `+1` tick para exactitud de 0.00°.
- **Servo 2 (TMR3 Software PWM con compensación de latencia):** Restableció Servo 2 en `TMR3` de alta prioridad con un factor de compensación calibrado a `+24` ticks, eliminando por completo la variación del ángulo inicial y logrando un error marginal de `0.11°` en la simulación.
- **Alineación de Rangos de Pulso (1.0 ms - 2.0 ms):** Corrigió los límites de pulso en `servo.h` (`SERVO_PULSE_MIN` a `2500` y `SERVO_PULSE_MAX` a `5000`) para alinearlos con el rango estándar de `1.0 ms` a `2.0 ms` que usa el modelo por defecto `MOTOR-PWMSERVO` de Proteus. Esto soluciona la no-linealidad donde ángulos menores a 45° quedaban saturados en `-90°`.

- **Acceso Atómico a TMR3 y Corrección de Tipos de Compilador (XC8):** Activé `RD16 = 1` en `T3CON` para asegurar que las escrituras del High/Low byte de TMR3 ocurran de forma atómica y eviten desbordamientos destructivos intermedios en la simulación. Suffixé `SERVO_FRAME_TICKS` a `50000U` para forzar operaciones unsigned de 16 bits nativas en XC8, evitando que el compilador truncara o promoviera incorrectamente los cálculos de reload con signo.

- **Telemetría de Diagnóstico de Parada de Emergencia (E-STOP):** Implementé la función `state_machine_estop_reason()` en `state_machine.c` y re-escribí las llamadas en `system.c` y `anti_jam.c`. Ahora, al gatillarse una parada de emergencia, el microcontrolador envía de inmediato un evento de telemetría UART con la razón exacta (`JAM:BELT_MOTOR_JAM`, `JAM:LASER_BEAM_BLOCKED` o `JAM:E_STOP_BUTTON`), el cual es interpretado por la TUI e impreso en la consola de logs. Esto permite saber con exactitud qué sensor o evento gatilló el paro.

- **Resolución de Reentrada del Compilador XC8 (Parada Involuntaria y JAM:UNKNOWN):** 
  - Diagnosticamos que el compilador XC8 no posee funciones matemáticas de 32 bits reentrantes. Al realizar restas de 32 bits en el lazo principal (`system_ticks - zero_speed_start`) mientras la interrupción alta (`isr_high`) o baja (`isr_low`) realizaban operaciones de 32 bits (como `65536UL - ticks` o el cálculo de velocidad `speed_mm_s`), los registros del acumulador de 32 bits se corrompían aleatoriamente. Esto provocaba que las comparaciones de tiempo dieran verdaderas de forma espontánea, disparando E-STOPs sin motivo y corrompiendo el puntero del parámetro `reason` (imprimiendo `JAM:UNKNOWN`).
  - **Acción 1:** Eliminamos todas las matemáticas de 32 bits de las interrupciones. La recarga de TMR3 en `servo.c` ahora usa `-ticks + 24` (negación pura de 16 bits inline).
  - **Acción 2:** Movimos la matemática de multiplicación/división de velocidad `speed_mm_s` fuera de `encoder_tick_handler()` (que corre en `isr_low`) a una nueva función `encoder_update_speed()`, la cual se ejecuta en el lazo principal (`state_machine_run`).
  - **Acción 3:** Eliminamos la reentrada de `state_machine_estop_reason` modificando la interrupción de `system.c` para que solo active la bandera `estop_triggered_by_button = 1`, procesándola de manera segura en el lazo principal.
  - **Acción 4:** Corregimos un bug en `ST_SORTING` que sobreescribía el estado a `ST_RUNNING` ignorando si se había declarado `ST_ERROR` durante la espera.

- **Optimización Asíncrona de Clasificación (ST_SORTING) y Fiabilidad UART:**
  - **Problema:** Encontré que la fase de clasificación (`ST_SORTING`) bloqueaba la CPU durante más de 500 ms usando bucles `while` de espera activa. Al bloquearse la CPU, `bt_protocol_process()` dejaba de ejecutarse, provocando que los comandos de Bluetooth enviados durante ese tiempo (como consultas de estado o comandos rápidos del servo) desbordaran el buffer de recepción UART de 64 bytes, resultando en caracteres perdidos y en errores `CMD_ERR:UNKNOWN` (obligando a reenviar comandos).
  - **Acción 1:** Convertí la fase `ST_SORTING` en una máquina de estados asíncrona basada en fases (`sorting_phase = 0, 1, 2`) y comparaciones no bloqueantes contra `system_ticks`. Ahora la CPU nunca se congela, permitiendo que la UART lea bytes instantáneamente en cada vuelta del lazo principal.
  - **Acción 2:** Agregué lógica de recuperación frente a errores de sobreflujo UART (Overrun Error - `OERR`) en `uart_isr_handler()` mediante el re-encendido de `CREN`, garantizando que la UART nunca se quede bloqueada permanentemente ante cualquier anomalía de simulación.

- **Inversión de Lógica en Sensores de Barrera (Break-beams):**
  - **Problema:** Las especificaciones de simulación indican que en reposo los pines de los sensores break-beam (`RD4` y `RD7`) deben mantenerse en `1` (luz pasa / libre) y cambiar a `0` (haz interrumpido / bloqueado) cuando un objeto pasa. Nuestro código original trataba el estado `1` como bloqueado y `0` como libre (lógica invertida), lo que causaría que al conectar los `LOGICSTATE` a `1` el sistema disparara de inmediato un error `LASER_BEAM_BLOCKED` tras 3 segundos.
  - **Solución:** Modifiqué `gpio_breakbeam_read()` en `gpio.c` para negar la lectura del puerto. Ahora, un pin en estado físico `1` (reposo) retorna `0` (Clear), y un pin en estado físico `0` (objeto presente) retorna `1` (Blocked), cumpliendo exactamente con las especificaciones de Proteus.

- **Menú de Calibración Local 100% Autónomo (Sin Bluetooth):**
  - **Problema:** La calibración manual local en el hardware mediante botones y LCD (`ST_TEST`) existía en el firmware pero solo era accesible si se enviaba un comando Bluetooth `TEST_ENTER` para cambiar el estado. Esto no cumplía con el requerimiento de "Calibración sin Bluetooth" (autónomo en hardware).
  - **Solución:**
    1. Implementé detección de pulsación larga en el botón `BTN_MODE` (pin `RD2`) mientras el sistema está en `ST_IDLE`. Si el botón se mantiene presionado por más de 2 segundos, el sistema entra autónomamente al modo de configuración local (`ST_TEST`).
    2. Agregué una opción de salida ("SALIR") como el 8vo elemento del menú local (`menu_index = 7`). Al seleccionarla y hacer una pulsación larga en `BTN_MODE`, el microcontrolador sale de `ST_TEST` y regresa al estado `ST_IDLE` de manera 100% autónoma.
    3. Eliminé la espera de 5 segundos tras el arranque para entrar al menú local si no ha habido comunicación Bluetooth (`last_bt_activity == 0`), permitiendo un acceso instantáneo al encender el equipo.

### Actualización (agy) - 2026-07-15 (Persistencia de Velocidad y UI de Colores)
- **Persistencia de Velocidad del Motor:**
  - **Firmware:** Agregué `state_machine_set_speed()` en `state_machine.c` y modifiqué `bt_protocol.c` para que el comando `SET_SPEED` guarde la velocidad en la variable `motor_speed`. Ahora la faja "recuerda" la última velocidad solicitada al arrancar de nuevo.
  - **TUI Dashboard:** Modifiqué `dashboard.py` para incluir una interfaz de ingreso directo del PWM del Motor (0-255), enviando el comando automáticamente.
- **Auto-registro de Colores en EEPROM:**
  - **Firmware:** Modifiqué `calibration_save_color()` en `calibration.c` para que al guardar un nuevo umbral de color con el comando `SET_THRESHOLD`, actualice automáticamente el contador interno `EEPROM_ADDR_NUM_CLR` si es necesario. Esto evita el bug lógico donde `num_colors` siempre era 0 al arrancar.
  - **TUI ConfigScreen:** Implementé una nueva sección "Registro de Colores (Umbrales)" en `config.py`. Proporciona campos visuales para ingresar el Índice y los valores Mín/Máx de Rojo, Verde y Azul (RGB). El botón de guardado compone y despacha el comando `SET_THRESHOLD` de forma transparente.

### Actualización (agy) - 2026-07-15 (Responsividad, Footers y Correcciones de Protocolo):
- **Resolución de Error Sintáctico TCSS y Botones Recortados en Móvil:** Dado que Textual CSS no soporta la directiva `@media` de CSS estándar, implementé responsividad a través del método `on_resize` en Python (añadiendo/removiendo la clase `.wide-screen`). 
  - Corregí un bug crítico de clipping lateral en celulares: al estar en formato horizontal (`Horizontal`), el quinto botón de la barra de control (**"Modo TEST"**) se recortaba fuera del borde derecho de la pantalla y era inaccesible. Ahora, los botones de control (`#dash-controls`) e input de velocidad (`#dash-speed-control`) se apilan verticalmente al 100% de ancho en celulares y regresan al formato horizontal en PC.
- **Anclaje de Botones de Retorno (`dock: bottom`):** Corregí el error de colapso de espacio vertical que recortaba los inputs de calibración de servos y ocultaba el visor de logs. Anclé los botones de retorno al extremo inferior de las pantallas (`ConfigScreen`, `TestScreen`, `LogViewerScreen`) usando el acoplamiento `dock: bottom` de Textual.
- **Estructura Expandible e Independiente (`height: 1fr`):** El cuerpo de las pantallas secundarias ahora se expande dinámicamente al 100% de la altura disponible. Las columnas de las pantallas `ConfigScreen` y `TestScreen` realizan scroll de manera independiente (`overflow-y: auto`), garantizando accesibilidad total sin importar la resolución.
- **Optimización en TestScreen:**
  - Compacté el formulario de servomotores alineando inputs y botones en una única línea horizontal (`test-row-inline`), ganando unos 7 renglones de alto.
  - Renombré el botón "Pulsar Motor" a **"Girar Motor (2s)"** para mayor claridad en español técnico.
- **Correcciones Críticas de Protocolo PIC-TUI:**
  - Modifiqué `protocol.py` para mapear `SERVO_CFG` a `SERVO_CONFIG` (permitiendo que las lecturas asíncronas de calibración de servos leídas desde la EEPROM por el PIC se auto-rellenen correctamente en la interfaz).
  - Mapeé la respuesta de encoder `ENC:` a `ENCODER_COUNT` para habilitar la lectura de pulsos en el modo de prueba.
- **Enrutador de Conexión Inteligente:** Modifiqué `action_connect()` en `app.py` para detectar automáticamente si la TUI corre bajo Termux en un celular Android. Si es así, prioriza la conexión TCP local (`127.0.0.1`) barriendo puertos comunes del puente Bluetooth (`8080`, `9000`, `1234`) instantáneamente para evitar esperas molestas por timeouts de puertos serie COM físicos. En PC, mantiene la prioridad de escaneo de puertos COM.

### Actualización (agy) - 2026-07-18 (Resolución de Motores, Servos y Conexión de Red LAN):
- **Corrección de Registros de Control de PWM (`firmware/pwm.c` y `firmware/system.c`):**
  - Se configuró explícitamente el registro de control `CCP1CON` a `0x0C` (salida simple P1A en el pin RC2) para impedir que el módulo ECCP del PIC active modos avanzados de puente que desvíen la señal.
  - Se forzó el encendido limpio del Timer2 fijando el registro `T2CON = 0x04` en `system_init()`.
- **Alineación de Frecuencia del L298N:**
  - Se bajó la frecuencia del PWM en `system.c` de 20kHz a **1.25kHz** ajustando el prescaler del Timer2 a 1:16 (`T2CON = 0x06`). Esto resolvió la lentitud de conmutación del puente H físico, permitiendo que la señal llegue correctamente al motor.
- **Solución de Desbordamiento de Precisión en PWM (`firmware/pwm.c`):**
  - Se corrigió un bug de desbordamiento en la multiplicación de la velocidad (`duty * 1000`) convirtiendo el operando temporal a `uint32_t`. Esto previno que el registro de comparación sufriera un overflow silencioso de 16 bits que limitaba el ciclo de trabajo a solo 19% de potencia, garantizando la fuerza de torque real requerida por el motor.
- **Calibración de Servos SG90 (`firmware/servo.h`):**
  - Se corrigieron los límites de pulso en el software para coincidir con las especificaciones físicas de los microservos SG90 (0.5 ms a 2.5 ms, representados por 1250 y 6250 ticks). Esto habilitó el rango de rotación real completo de 180° (barrido de -90° a +90°).
- **Enrutamiento del Test de Servos en la TUI (`tui_app/app.py`):**
  - Se solucionó el bug de enrutamiento donde el mensaje `SERVO_CONFIG` del PIC no era enviado a la pantalla de pruebas. Ahora `TestScreen` recibe y procesa correctamente el estado de calibración, permitiendo que los botones "Probar Home" y "Probar Deflect" funcionen en tiempo real.
  - Se añadió el registro de comandos salientes (`Enviado: ...`) en `connect.py` hacia `tui_log.txt` para mejorar la depuración del protocolo.
- **Parámetros CLI para Redes LAN:**
  - Se agregaron parámetros de línea de comandos (`--ip`, `--port`, `--serial`) en la inicialización de la TUI. Esto permite abrir la interfaz de forma remota en la PC mediante cable de red (RJ45) o WiFi, estableciendo conexión TCP directamente con la IP de la app "Bluetooth TCP Bridge" en el celular (`python app.py --ip <IP_CELULAR>`).
- **Instrucciones para Conexión del TCS34725:**
  - Se documentó el conexionado en paralelo I2C para compartir las líneas SDA (RB0) y SCL (RB1) entre la pantalla LCD y el sensor de color, además de proveer guía técnica sobre el colapso del bus cuando alguna línea se cortocircuita a tierra.
- **Implementación de Pruebas en Tiempo Real del Sensor de Color (TCS34725):**
  - **Firmware:** Se agregó el comando `TEST_COLOR` en `bt_protocol.c` que realiza la lectura asíncrona de los 4 canales de color (R, G, B, C) mediante `tcs34725_get_raw` y los reporta por la UART con el formato estructurado `COLOR:<r>,<g>,<b>,<c>`.
  - **TUI Screens:** Se agregó una nueva tarjeta "Sensor de Color TCS34725" en la pantalla de pruebas (`TestScreen`) para visualizar de forma reactiva los valores crudos de lectura.
  - **TUI Polling:** Se integró la petición `TEST_COLOR` en la llamada recurrente de `poll_hardware()` de la pantalla de pruebas para refrescar la lectura en tiempo real.
  - **Estilos:** Se incorporó la clase `.color-indicator` en `app.tcss` para el estilizado alineado de los indicadores de canal.
- **Detección de Desconexión TCP Física y Vista Previa de Color Estimada:**
  - **TUI (connect.py):** Se corrigió el bug de estado "Conectado" persistente. Ahora, si el PIC se apaga y el canal TCP lee un string vacío `b''` (EOF), se gatilla la desconexión inmediata en el cliente fijando `self._connected = False` para que la TUI refleje la desconexión real y detenga el polling.
  - **TUI (TestScreen):** Se agregó la tarjeta visual "Color Dominante Estimado" y la lógica en `update_color_raw` para calcular por software el color preponderante (Rojo, Verde o Azul) comparando magnitudes relativas RGBC en vivo. Esto permite calibrar y verificar visualmente qué color está observando el sensor al instante en el monitor.
- **Optimización de Latencia y Velocidad de Lectura del Sensor de Color:**
  - **Firmware (tcs34725.c):** Se redujo el tiempo de integración de la conversión del ADC del sensor TCS34725 de 50.4ms (`0xEB`) a **24ms** (`0xF6`). Para compensar la menor acumulación de fotones y no perder rango dinámico frente al ruido, se cuadruplicó la ganancia óptica interna configurándola a **16x** (`2`) en lugar de 4x (`1`). Esto aceleró sustancialmente la velocidad de refresco física del chip.
  - **TUI (screens/test_screen.py):** Se redujo el intervalo de polling asíncrono de hardware de 500ms a **200ms**, logrando una respuesta en pantalla inmediata y sumamente fluida.
- **Robustez en la Comunicación Serial (Evitar Congestión y Bloqueos de UART):**
  - **Firmware (bt_protocol.c):** Se implementó una rutina de seguridad al inicio de `bt_protocol_process()` que detecta si el bit de error de sobreflujo de hardware (`RCSTAbits.OERR`) está activo y lo limpia ciclando el receptor (`CREN = 0` y `CREN = 1`). Esto evita que el receptor UART del PIC se bloquee si llegan muchos bytes juntos.
  - **Comando Unificado `TEST_POLL`:** Se eliminaron las tres peticiones concurrentes individuales (`TEST_BEAM`, `TEST_BUTTON_ECHO`, `TEST_COLOR`) que saturaban el canal de transmisión. En su lugar se creó el comando unificado `TEST_POLL`. El PIC lee todos los sensores de una sola pasada y responde con una sola línea optimizada (`POLL_RESP:CC,000,r,g,b,c`).
  - **TUI (protocol.py, app.py, test_screen.py):** Se adaptó el flujo de datos para enviar únicamente `TEST_POLL` cada 200ms y parsear la respuesta en un solo bloque, reduciendo el tráfico serial en más de un 60% y eliminando retrasos de lectura.
- **Velocidad de Emergencia del Encoder (Bypass de Velocidad 0 para Pruebas):**
  - **Firmware (state_machine.c):** En la fase 0 del estado `ST_SORTING`, el sistema requiere medir una velocidad del motor mayor a 0 para calcular el retraso de arribo de la pieza al servo (`transit_ms`). Si el encoder está desconectado físicamente o no registra pulsos, la velocidad medida es 0, lo que provocaba un aborto inmediato volviendo a `ST_RUNNING` en la misma tarea. Se programó un fallback: si la velocidad del encoder es 0, el software asume una velocidad fija por defecto de `100` mm/s, permitiendo completar el ciclo de clasificación y mover los servos para pruebas de clasificación automática.
