gmoca/fajaClasificadora/(list of files, drawings)

Other design files:
SquemaProteus/Project Backups/pryFaja [20260715, 10-45-38].pdsprj
SquemaProteus/pryFaja.pdsprj
