gmoca/fajaClasificadora/firmware/pwm.c

#include "pwm.h"
#include "config.h"

void pwm_hbridge_init(void) {
    CCP1CON = 0x0C;  // Single output PWM, P1A (RC2) active-high
    CCPR1L = 0;
    TRISCbits.TRISC2 = 0;
}

void pwm_hbridge_set_duty(uint8_t duty) {
    // Escalar de 0-255 a 0-1000 (resolución máxima de PR2 = 249)
    // Usamos uint32_t para evitar desbordamiento de enteros de 16 bits en la multiplicación (duty * 1000)
    uint16_t val = ((uint32_t)duty * 1000) / 255;
    CCPR1L = val >> 2;
    CCP1CONbits.DC1B = val & 0x03;
}
