gmoca/fajaClasificadora/(commit log)

2026-07-14 feat: sistema completo de faja transportadora clasificadora
    PIC18F4550 firmware (XC8 v3.10, C99):
    - Drivers HAL: GPIO, UART 115200, I2C 100kHz, LCD 1602, TCS34725, PWM 20kHz
    - Servo CCP2 Compare + software PWM, encoder INT2 con velocidad mm/s
    - Máquina de estados: IDLE, RUNNING, SORTING, ERROR, TEST
    - Protocolo BT: START, STOP, SET_SPEED, SET_MODE, SERVO, SET_THRESHOLD
    - Anti-jam: encoder belt jam + break-beam blockage detection
    - Calibración por EEPROM con layout según spec
    TUI Python + Textual (4 pantallas):
    - Dashboard, Config, Log Viewer, Test & Calibration
    - BTManager asíncrono con auto-reconnect cada 3s
    - Protocolo de telemetría bidireccional
    45% flash, 34.6% RAM usados.
    [anti_jam.c, app.py, bt_protocol.c, calibration.c, calibration.h, config.h]
2026-07-14 feat: EEPROM init, LCD cyclic editor, correcciones compilador
    agy:
    - calibration_init() con defaults si EEPROM sin magic byte
    - Menú LCD cyclic editor (7 parámetros, MODE/UP/DOWN, long-press guarda)
    - Servo config EEPROM: save_home/deflect/dwell, save_ppr, read/write_word
    - last_bt_activity tracking, salida automática del menú al recibir UART
    OpenCode:
    - Fix ultoa -> conversión manual en TEST_ENCODER_READ
    - Fix #include <string.h> en calibration.c para strcpy/strcat
    - Fix calibration_save_servo_home() firma (2 args)
    - Build: 56% flash, 42.7% RAM
    [bt_protocol.c, calibration.c, calibration.h, gpio.c, gpio.h, main.c, state_machine.c]
2026-07-14 feat: servo2 con TMR3, docs assembly/HC-05, fixes TUI y dependencias
    - Servo2 reimplementado: TMR3 ISR a 25us (~3° resolucion),
    autonomo sin polling en main loop
    - servo_get_angle() para leer angulo fisico actual
    - SET_DWELL <sid> <ms> en bt_protocol.c
    - ConfigScreen: interfaz para guardar home/defl/dwell de servos
    - app.py: fix query_one selectors para Textual
    - pyproject.toml: +pyserial-asyncio
    - docs/hc05-setup.md: guia configuracion HC-05 modo AT
    - docs/assembly-guide.md: pinout, rieles de poder, conexiones
    - start.bat + start.sh: lanzadores automaticos TUI
    [app.py, bt_protocol.c, config.py, servo.c, servo.h, system.c]
2026-07-14 feat: soporte TCP bridge para Termux + documentacion
    - connect.py: connect_tcp() para Serial Bluetooth Terminal
    - app.py: fallback a TCP 127.0.0.1:8080 en action_connect()
    - docs/termux-setup.md: guia completa Termux (3 metodos BT)
    - start.sh/start.bat: recordatorio conexion Bluetooth
    - CHECKLIST.md, Journal.md actualizados
2026-07-14 fix: deteccion de SO en TUI + CMODE=1 en HC-05 guide
    - app.py: action_connect() prueba puertos segun platform.system()
    - hc05-setup.md: CMODE=0 sin BIND dejaba HC-05 incomunicado, cambiado a CMODE=1
    - Journal.md actualizado
    [app.py]
2026-07-14 fix: conexiones de hardware y logica de clasificacion
    - gpio.c: TRISD7 explicito para break-beam RX 2
    - state_machine.c: SORTING usa angulos desde EEPROM (home/defl),
    no valores hardcodeados 0/90
    - bt_protocol.c: TEST_BEAM parsea parametro de estacion (1 o 2),
    respuesta con BEAM:<stn>:B|C (B=broken, C=clear)
    - encoder.c: ROLLER_MM entero (sin float en PIC), speed_mm_s a uint32
    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
    [bt_protocol.c, encoder.c, gpio.c, state_machine.c]
2026-07-14 fix: reubicacion de E-Stop a RB3 y habilitacion de I2C en RB0/RB1
    [calibration.c, gpio.c, i2c.c, system.c]
2026-07-14 Revert "fix: reubicacion de E-Stop a RB3 y habilitacion de I2C en RB0/RB1"
    This reverts commit 7d6f5070126ae76d064678d45949ff33ff2732e9.
    [calibration.c, gpio.c, i2c.c, system.c]
2026-07-14 fix: re-aplicar pines correctos I2C (RB0/RB1) e E-stop (RB3) tras clarificar conflicto en PIC18F4550
    [calibration.c, gpio.c, i2c.c, system.c]
2026-07-14 docs: pinout PIC18F4550 como regla obligatoria en AGENTS.md + handoff definitivo para OpenCode
2026-07-14 debug: mover uart_init al inicio de main para diagnosticar cuelgues
2026-07-14 fix: resolver cuelgue infinito en ISR de transmision UART
    [system.c]
2026-07-14 fix: configurar prioridades bajas para TXIP y TMR0IP para evitar bucles infinitos en isr_high
    [system.c, uart.c]
2026-07-14 docs: registrar detalles de resolucion de prioridades de interrupcion en Journal y Handoff
2026-07-14 debug: agregar escaneo de bus I2C al arranque para detectar direccion del LCD en la UART
2026-07-14 fix: cambiar LCD_ADDR a 0x27 para coincidir con A0-A2 conectados a 5V
    [lcd.h]
2026-07-14 docs: actualizar Journal y Handoff con la resolucion final del LCD en direccion 0x27
2026-07-15 fix: implementar i2c_wait_idle para evitar colisiones de escritura en SSPBUF
    [i2c.c]
2026-07-15 feat: agregar diagnostico detallado de arranque por UART, debug_print y i2c_scan
2026-07-15 docs: registrar la implementacion de diagnostico de arranque en Journal
2026-07-15 fix: agregar esperas activas en EECON1bits.RD para evitar colisiones de EEPROM en simulacion
    [calibration.c]
2026-07-15 fix: configurar SPBRG_VAL directamente a 42 en config.h para evitar errores de redondeo
    [config.h]
2026-07-15 feat: agregar respuestas de ACK e unknown_command a la UART en el parser BT
2026-07-15 fix: agregar definicion local de u16_to_str en bt_protocol.c
    [bt_protocol.c]
2026-07-15 fix: corregir bits CCP2M de 0b0101/0b0111 a Compare mode 0b1001/0b1011 para restaurar Servo 1
    [servo.c]
2026-07-15 fix: simplificar servo_ccp2_isr a 2 fases para asegurar timing correcto de Servo 1
    [servo.c]
2026-07-15 fix: precalcular pasos de servo 2 fuera del ISR y mapear CCP2MX a RC1
    [config.h, servo.c]
2026-07-15 fix: refactorizar control de Servo 1 a software PWM unificado con Servo 2 en Timer 3, y deshabilitar ordenamiento si no hay sensor de color
    [servo.c, servo.h, state_machine.c, system.c, tcs34725.c, tcs34725.h]
2026-07-15 fix: recargar TMR3 al inicio de la ISR para eliminar jitter en las señales PWM de servos
    [servo.c]
2026-07-15 fix: optimizar frecuencia de ISR a 50us y extender rango de pulsos de servo a 0.5ms-2.5ms
    [servo.c, servo.h]
2026-07-15 fix: asignar TMR3 software PWM a la ISR de alta prioridad para eliminar completamente el jitter e inestabilidad
    [servo.c, system.c]
2026-07-15 feat: fix compiler reentrancy, anti-jam, UART reliability, and active-low break-beams
    [anti_jam.c, encoder.c, encoder.h, gpio.c, servo.c, servo.h, state_machine.c, state_machine.h]
2026-07-15 feat: enable standalone local calibration menu entry/exit via BTN_MODE long press
2026-07-15 fix: make button state variables volatile to prevent compiler optimization
    [gpio.c]
2026-07-15 fix: consume button edge during state transition to prevent immediate bounce-back
    [state_machine.c]
2026-07-15 fix: replace system_ticks blocking loops with safe __delay_ms in menu transitions
    [state_machine.c]
2026-07-15 fix: implement timeouts in all I2C loops to prevent physical or simulated locks from hanging the CPU
    [i2c.c]
2026-07-15 fix: refactor all LCD writes to be strictly time-based (every 500ms) to prevent I2C bus traffic congestion and simulator locks
    [state_machine.c]
2026-07-15 fix: pad BT OK to full LCD line size to erase leftover characters and optimize I2C timeouts
    [i2c.c, state_machine.c]
2026-07-15 fix: replace __delay_ms(800) with loop-based safe_delay_ms(800) to prevent XC8 inline delay overflow hangs
    [state_machine.c]
2026-07-15 fix: remove redundant EECON1bits.RD loops in EEPROM reads to prevent Proteus lockups during block loads
    [calibration.c]
2026-07-15 fix: refactor state machine ST_TEST to be 100% event-driven and non-blocking, eliminating all delay calls and unused safe_delay_ms function
    [state_machine.c]
2026-07-15 fix: move idle button state variables to file scope and reset them on state transitions to prevent locked button states
    [state_machine.c]
2026-07-15 chore: Add Proteus simulation file
    [pryFaja [20260715, 10-45-38].pdsprj, pryFaja.pdsprj]
2026-07-15 TUI improvements: responsive layouts, docked footers, protocol fixes, and Termux connection routing
    [app.py, config.py, dashboard.py, log_viewer.py, protocol.py, test_screen.py]
2026-07-15 TUI: fix dashboard controls clipping on mobile by vertically stacking buttons and inputs
2026-07-16 fix: ignore decode errors in BT stream
    [connect.py]
2026-07-16 fix: Add file logging and increase timeout in connect.py
    [connect.py]
2026-07-16 fix: Log exceptions in update_dashboard to tui_log.txt
    [app.py]
2026-07-16 fix: Prevent NoMatches screen exceptions in app.py
    [app.py]
2026-07-16 debug: Enable I2C scanner and debug print on boot
2026-07-16 debug: Temporarily comment out motor jam check
    [anti_jam.c]
2026-07-16 fix: Scale PWM duty cycle from 0-255 to 0-1000 range
    [pwm.c]
2026-07-17 fix: Direct register configuration for T2CON and CCP1CON
    [pwm.c, system.c]
2026-07-17 fix: Restore scaled PWM duty cycle with robust register setup
    [pwm.c]
2026-07-17 fix: Lower PWM frequency to 1.25kHz for L298N compatibility
    [system.c]
2026-07-17 fix: Prevent 16-bit integer overflow in PWM duty cycle calculation
    [pwm.c]
2026-07-17 fix: Adjust servo pulses to SG90 standard 0.5ms-2.5ms
    [servo.h]
2026-07-17 fix: Add outbound cmd logging and route SERVO_CONFIG to TestScreen
    [app.py, connect.py]
2026-07-18 fix: Update __init__ in FajaApp to accept host and port parameters
    [app.py]
2026-07-18 feat: Add raw color sensor polling and display in TUI TestScreen
2026-07-18 docs: Document raw color sensor testing in journal and handoff
2026-07-18 fix: Handle TCP EOF disconnect and add estimated live color preview in TestScreen
    [connect.py, test_screen.py]
2026-07-18 docs: Document EOF TCP socket disconnect and live color estimator
2026-07-18 fix: Raise live color estimator clear threshold to 150 to avoid ambient noise
    [test_screen.py]
2026-07-18 perf: Speed up color sensor integration time to 24ms and increase TUI poll rate to 200ms
2026-07-18 fix: Improve color preview heuristic using relative ratio calculations
    [test_screen.py]
2026-07-18 feat: Add OERR recovery and unified TEST_POLL command to avoid buffer overruns
    [app.py, bt_protocol.c, protocol.py, test_screen.py]
2026-07-18 fix: Implement keepalive heartbeat timeout to handle zombie Android TCP connections when PIC is powered off
    [app.py]
2026-07-19 fix: Correct function call gpio_breakbeam_read in bt_protocol.c
    [bt_protocol.c]
2026-07-19 fix: Replace periodic poll_bluetooth timer with a continuous receive_loop task to solve read queue lag
    [app.py]
2026-07-19 feat: Add encoder speed fallback in ST_SORTING to prevent instant abort when speed is 0
    [state_machine.c]
2026-07-19 docs: Document encoder fallback speed in handoff
2026-07-19 feat: Make sorting distance configurable for both servos via TUI and physical LCD menu
2026-07-19 fix: Make servos return to home position after save routine completes
    [config.py]
2026-07-19 feat: Add dynamic servo routing (0=none, 1=servo 1, 2=servo 2) for color thresholds
2026-07-19 feat: Add TabbedContent layout to color calibration thresholds screen in TUI
2026-07-19 feat: Implement encoder pulse spacing check (with temporal cooldown fallback) to prevent duplicate detections
    [state_machine.c]
2026-07-19 feat: Synchronize and display current PWM duty cycle dynamically on TUI Dashboard and Config screens
